legenscar/ATK-VXE-R1-SE-SEPRO-Fingertip-mod/R1/Right mouse button.stl

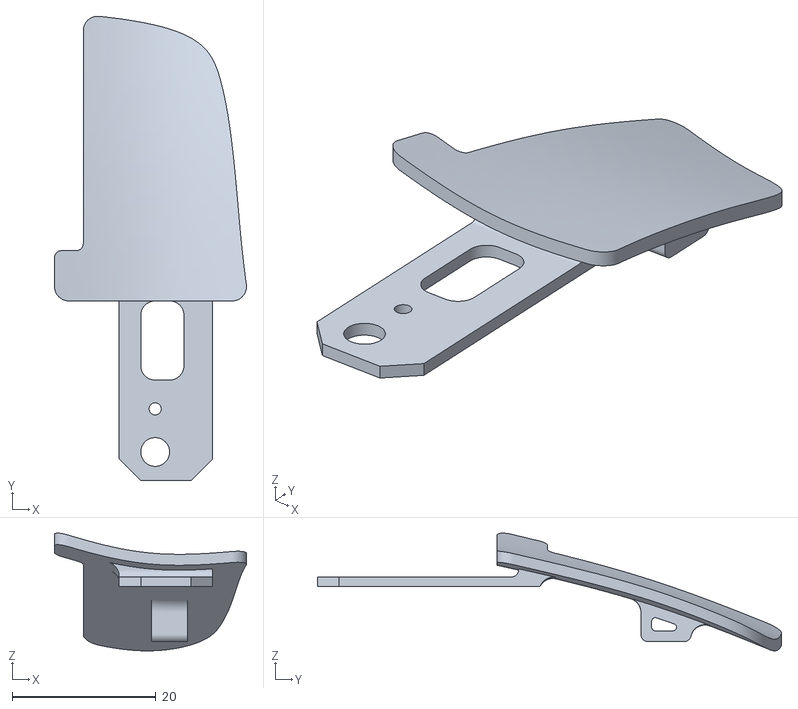
[picture p1: CAD file, 2026-11-08]
R1/Right mouse button.stl
26.7 x 64.6 x 16.4
