legenscar/ATK-VXE-R1-SE-SEPRO-Fingertip-mod/STL files/R1 Pro/R1pro_Base.step

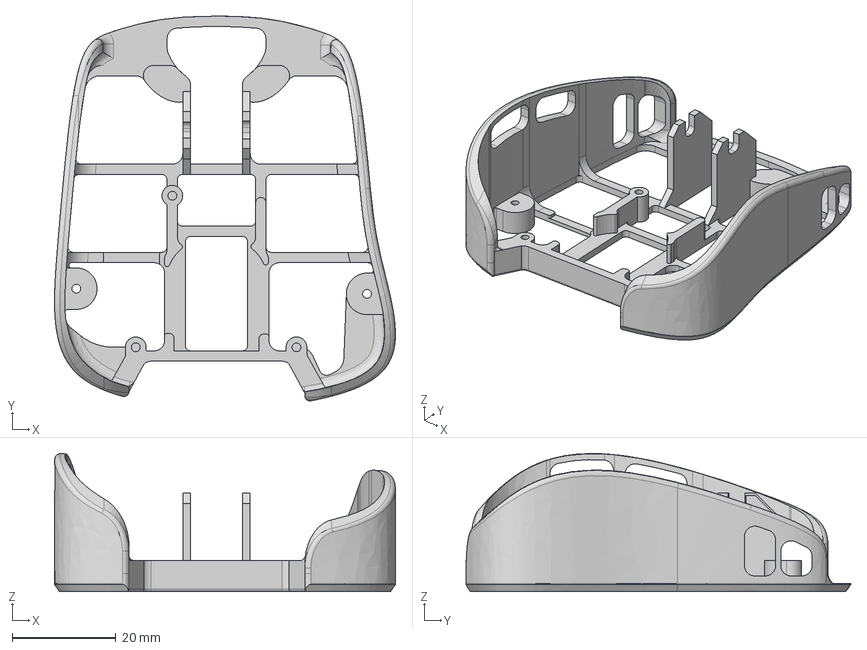
[picture p2: CAD file, 2026-10-23]
STL files/R1 Pro/R1pro_Base.step
65.7 x 74.1 x 26.6 mm
