legenscar/ATK-VXE-R1-SE-SEPRO-Fingertip-mod/STL files/R1 SE+/R1 SE+.step

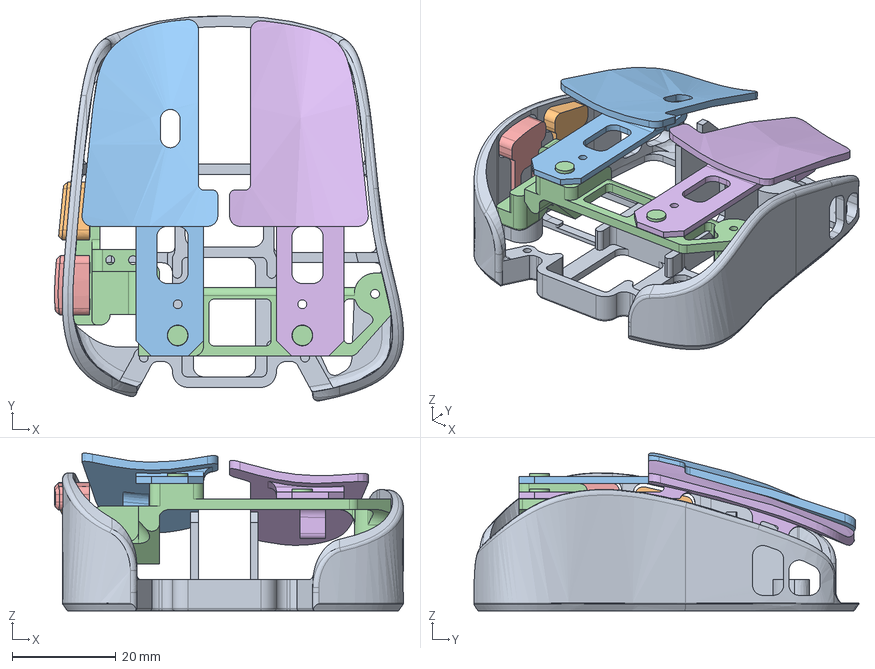
[picture p3: CAD file, 2026-10-27]
STL files/R1 SE+/R1 SE+.step
67.2 x 74.1 x 30.4 mm
Base
side2
LMB
support
side1
RMB
