legenscar/ATK-VXE-R1-SE-SEPRO-Fingertip-mod/STL files/R1pro_Wheel.stl

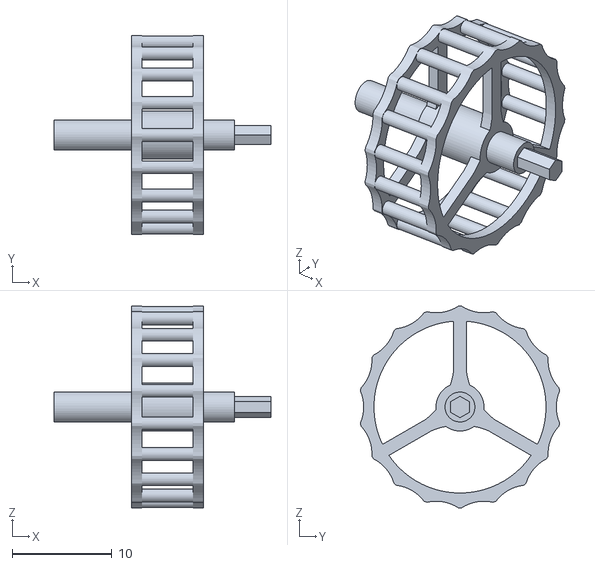
[picture p4: CAD file, 2026-10-31]
STL files/R1pro_Wheel.stl
21.8 x 20.0 x 20.2
