legenscar/ATK-VXE-R1-SE-SEPRO-Fingertip-mod/R1/Left mouse button.stl

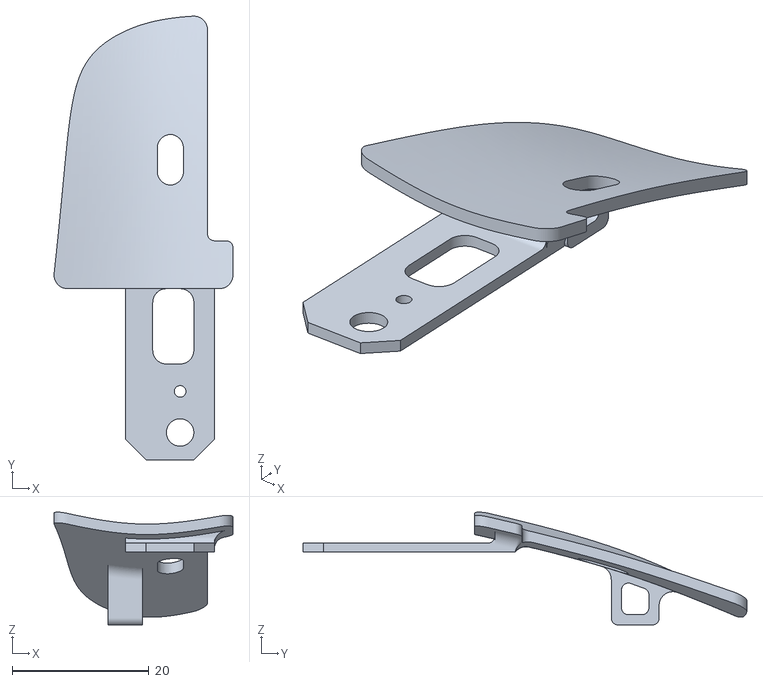
[picture p5: CAD file, 2026-11-08]
R1/Left mouse button.stl
26.1 x 64.8 x 16.5
