legenscar/ATK-VXE-R1-SE-SEPRO-Fingertip-mod/STL files/R1 Pro/R1pro_Support.step

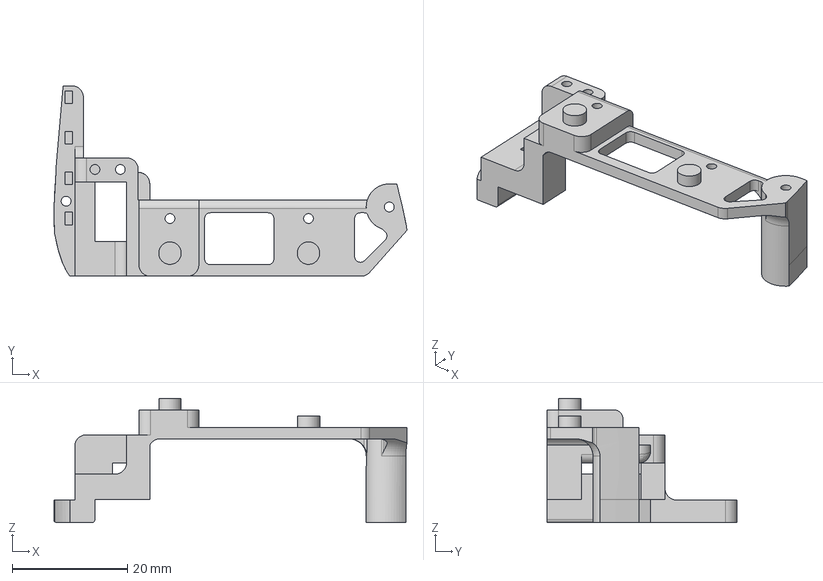
[picture p6: CAD file, 2026-10-23]
STL files/R1 Pro/R1pro_Support.step
61.2 x 33.0 x 21.5 mm
