legenscar/ATK-VXE-R1-SE-SEPRO-Fingertip-mod/R1/side button 1.stl

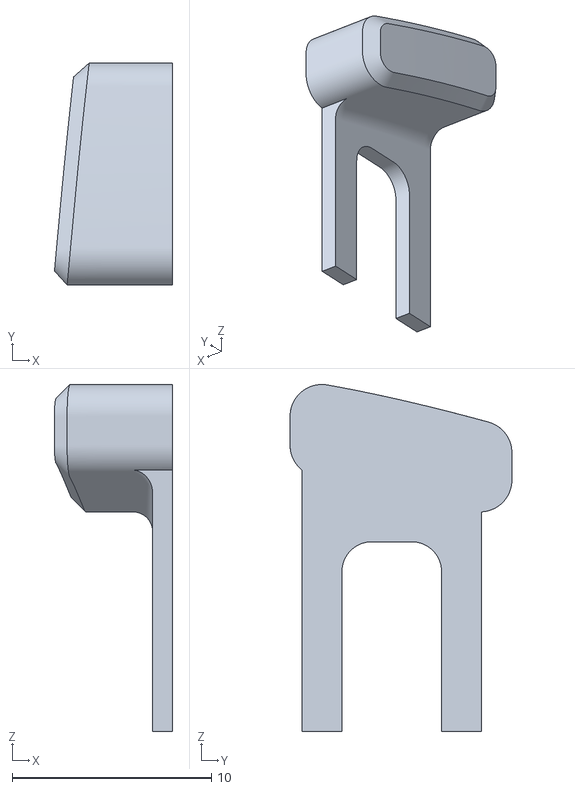
[picture p7: CAD file, 2026-11-08]
R1/side button 1.stl
5.93 x 11.1 x 17.4
