legenscar/ATK-VXE-R1-SE-SEPRO-Fingertip-mod/R1/side button 2.stl

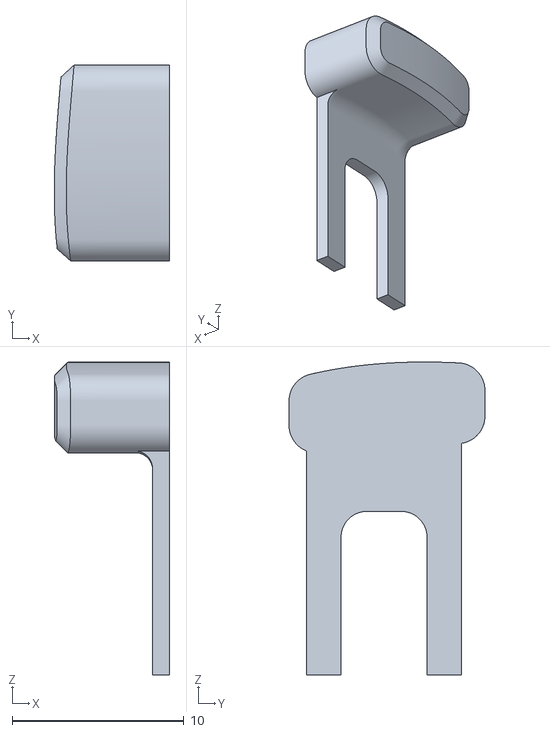
[picture p8: CAD file, 2026-11-08]
R1/side button 2.stl
6.72 x 11.4 x 18.2
