legenscar/ATK-VXE-R1-SE-SEPRO-Fingertip-mod/R1/R1Standard_Base_v2.stl

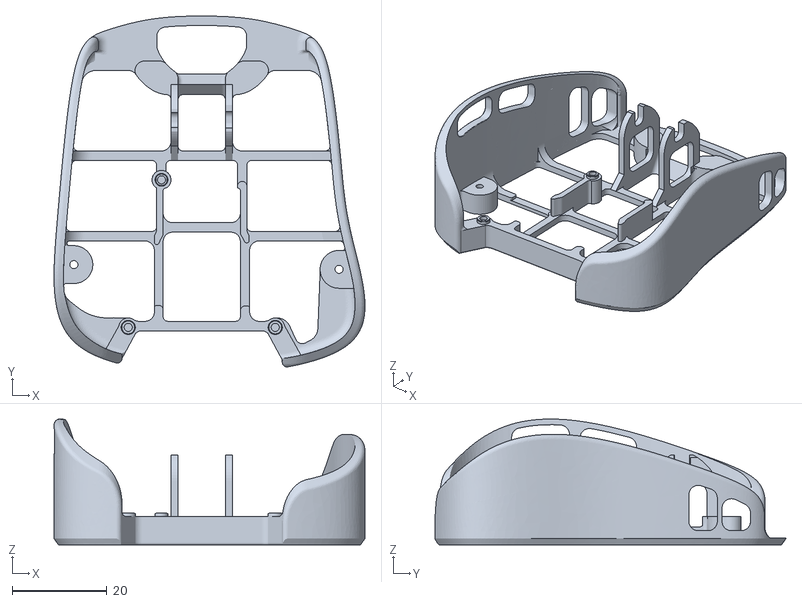
[picture p9: CAD file, 2026-11-08]
R1/R1Standard_Base_v2.stl
65.7 x 74.1 x 26.6
