legenscar/ATK-VXE-R1-SE-SEPRO-Fingertip-mod/R1/Support.stl

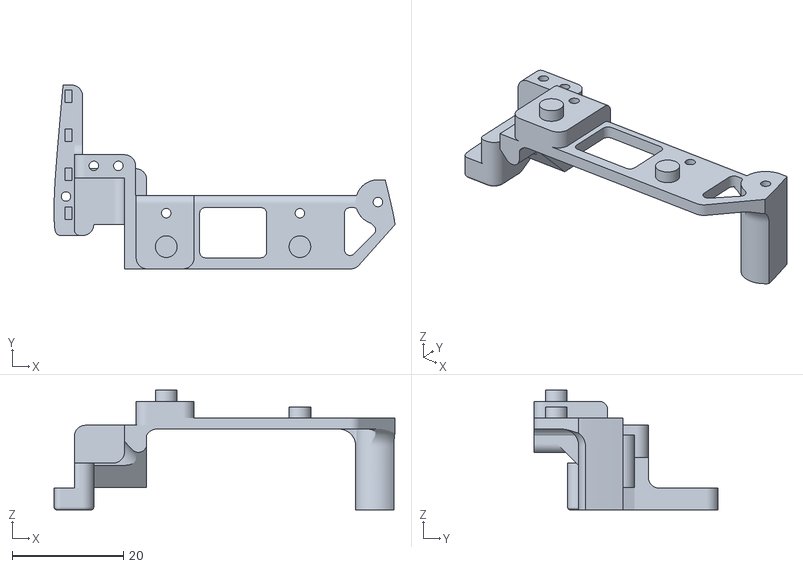
[picture p10: CAD file, 2026-10-23]
R1/Support.stl
61.2 x 33.0 x 21.5
