legenscar/ATK-VXE-R1-SE-SEPRO-Fingertip-mod/(list of files, cad)

Other CAD files:
STL files/R1 SE+/Base.stl
