legenscar/ATK-VXE-R1-SE-SEPRO-Fingertip-mod/(commit log)

2026-08-26 added step files
    [VXE R1 SE+ FT mod.step]
2026-10-23 Revise README with new images and printing notes
    Updated images and added notes about printing materials and printer settings.
2026-10-23 Rename VXE R1 SE+ FT mod.step to STL files/VXE R1 SE+ FT mod.step
    [VXE R1 SE+ FT mod.step]
2026-10-23 Rename STL files/Base.stl to STL files/R1 SE+/Base.stl
    [Base.stl]
2026-10-23 Rename STL files/VXE R1 SE+ FT mod.step to STL files/R1 SE+/VXE R1 SE+ FT mod.step
    [VXE R1 SE+ FT mod.step]
2026-10-23 Rename STL files/Support.stl to STL files/R1 SE+/Support.stl
    [Support.stl]
2026-10-23 Rename STL files/R1pro_Base.step to STL files/R1 Pro/R1pro_Base.step
    [R1pro_Base.step]
2026-10-23 Add R1pro_Support.step file
    [R1pro_Support.step]
2026-10-23 Clarify STL/STEP file references in README
    Updated file references and clarified instructions for printing.
2026-10-24 Update assembly instructions for R1 pro model
    Added warning about differences in R1 pro sensor lens and PCB.
2026-10-31 Rename R1pro_Wheel (2).stl to R1pro_Wheel.stl
    [R1pro_Wheel.stl]
